williamlin108/Olympus-BH-2-LED-Module-G031xMAX20078/PCBfiles/3d_Lib/21-0136V_T16334C_MXM.step

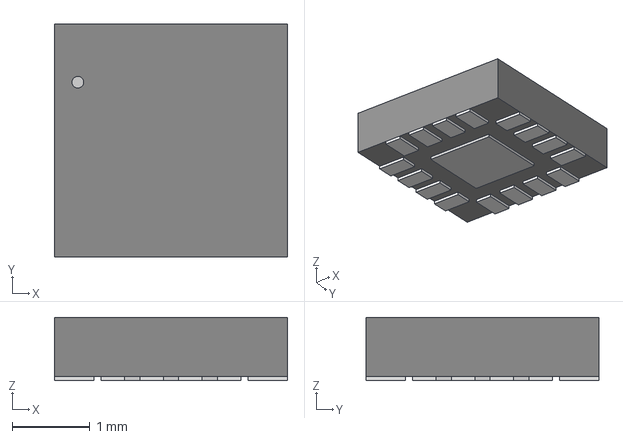
[picture p4: CAD file, 2026-10-14]
PCBfiles/3d_Lib/21-0136V_T16334C_MXM.step
3.00 x 3.00 x 0.815 mm
