williamlin108/Olympus-BH-2-LED-Module-G031xMAX20078/PCBfiles/3d_Lib/Molex_SPOX_5267.step

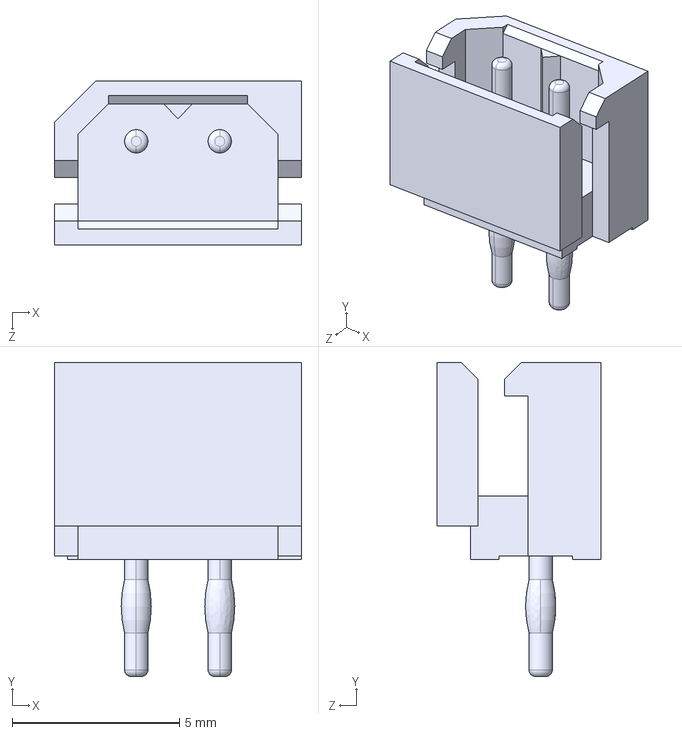
[picture p5: CAD file, 2026-10-14]
PCBfiles/3d_Lib/Molex_SPOX_5267.step
7.40 x 9.40 x 4.90 mm
