williamlin108/Olympus-BH-2-LED-Module-G031xMAX20078/PCBfiles/3d_Lib/d2f-01l3-t.stp

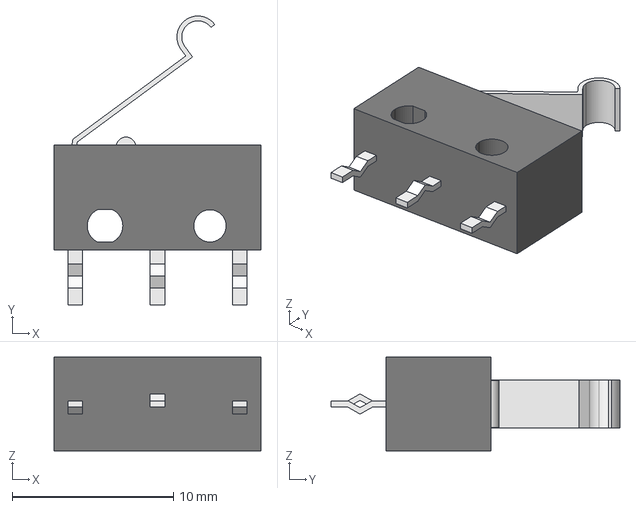
[picture p6: CAD file, 2026-10-14]
PCBfiles/3d_Lib/d2f-01l3-t.stp
12.8 x 17.9 x 5.80 mm
