williamlin108/Olympus-BH-2-LED-Module-G031xMAX20078/PCBfiles/3d_Lib/D2F_01FL2_A1.step

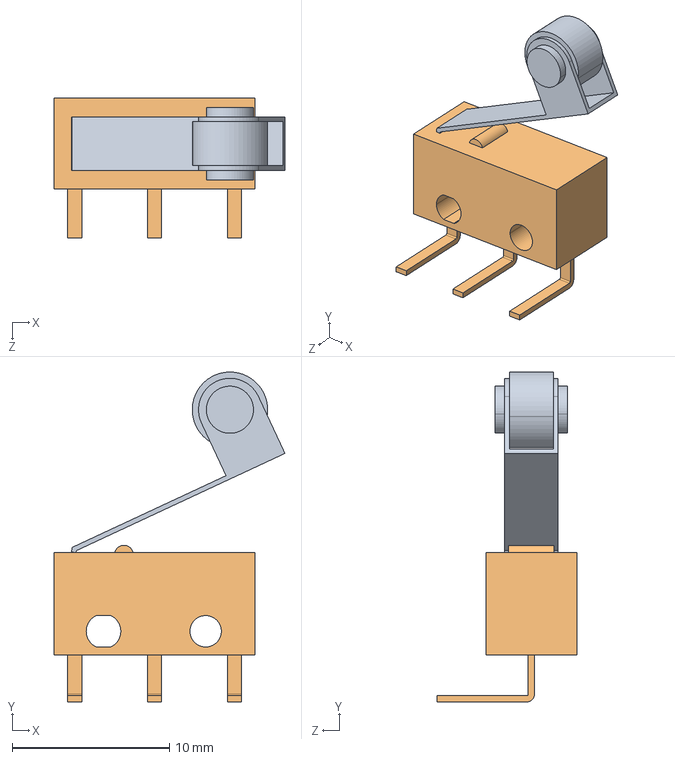
[picture p7: CAD file, 2026-10-14]
PCBfiles/3d_Lib/D2F_01FL2_A1.step
14.7 x 21.0 x 8.90 mm
D2F_01FL2_A1_ACTUATOR
D2F_01FL2_A1_BASE
