williamlin108/Olympus-BH-2-LED-Module-G031xMAX20078/PCBfiles/3d_Lib/infineon-pg-tison-8-4-3d-01-stp-package-en.stp

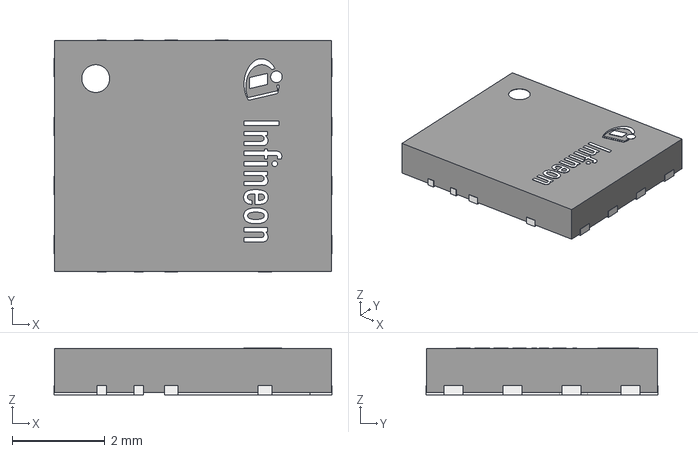
[picture p8: CAD file, 2026-10-14]
PCBfiles/3d_Lib/infineon-pg-tison-8-4-3d-01-stp-package-en.stp
6.00 x 5.00 x 1.01 mm
