williamlin108/Olympus-BH-2-LED-Module-G031xMAX20078/PCBfiles/3d_Lib/CYPD3177-24LQXQ--3DModel-STEP-510211.STEP

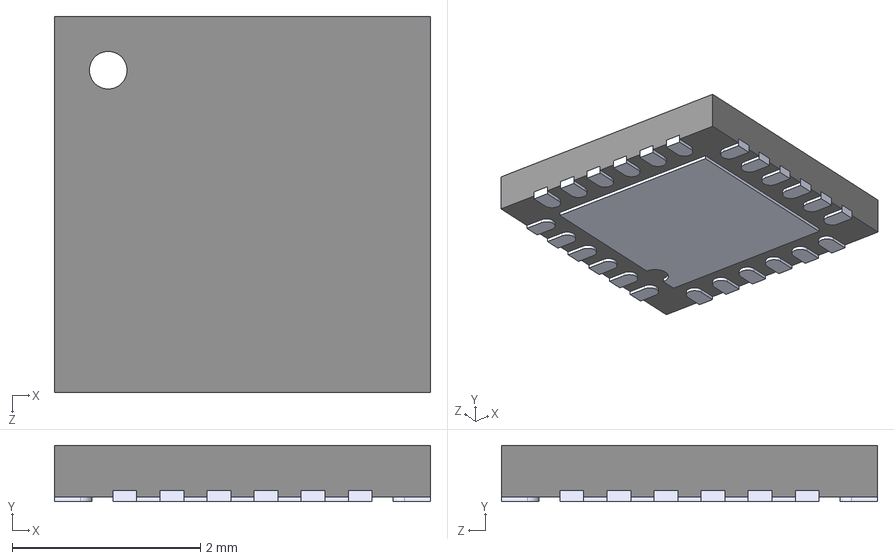
[picture p9: CAD file, 2026-10-14]
PCBfiles/3d_Lib/CYPD3177-24LQXQ--3DModel-STEP-510211.STEP
4.00 x 0.6 x 4.00 mm
EXPORT__Body__S01^QFN(2)_CYPD3177-24LQXQ
EXPORT__Body001__S01^QFN(2)_CYPD3177-24LQXQ
EXPORT__Body001__S02^QFN(2)_CYPD3177-24LQXQ
EXPORT__Body001__S03^QFN(2)_CYPD3177-24LQXQ
EXPORT__Body001__S04^QFN(2)_CYPD3177-24LQXQ
EXPORT__Body001__S05^QFN(2)_CYPD3177-24LQXQ
EXPORT__Body001__S06^QFN(2)_CYPD3177-24LQXQ
EXPORT__Body001__S07^QFN(2)_CYPD3177-24LQXQ
EXPORT__Body001__S08^QFN(2)_CYPD3177-24LQXQ
EXPORT__Body001__S09^QFN(2)_CYPD3177-24LQXQ
EXPORT__Body001__S10^QFN(2)_CYPD3177-24LQXQ
EXPORT__Body001__S11^QFN(2)_CYPD3177-24LQXQ
EXPORT__Body001__S12^QFN(2)_CYPD3177-24LQXQ
EXPORT__Body002__S01^QFN(2)_CYPD3177-24LQXQ
EXPORT__Body002__S02^QFN(2)_CYPD3177-24LQXQ
EXPORT__Body002__S03^QFN(2)_CYPD3177-24LQXQ
EXPORT__Body002__S04^QFN(2)_CYPD3177-24LQXQ
EXPORT__Body002__S05^QFN(2)_CYPD3177-24LQXQ
EXPORT__Body002__S06^QFN(2)_CYPD3177-24LQXQ
EXPORT__Body002__S07^QFN(2)_CYPD3177-24LQXQ
EXPORT__Body002__S08^QFN(2)_CYPD3177-24LQXQ
EXPORT__Body002__S09^QFN(2)_CYPD3177-24LQXQ
EXPORT__Body002__S10^QFN(2)_CYPD3177-24LQXQ
EXPORT__Body002__S11^QFN(2)_CYPD3177-24LQXQ
EXPORT__Body002__S12^QFN(2)_CYPD3177-24LQXQ
EXPORT__Body003__S01^QFN(2)_CYPD3177-24LQXQ
EXPORT__Body004__S01^QFN(2)_CYPD3177-24LQXQ
