williamlin108/Olympus-BH-2-LED-Module-G031xMAX20078/PCBfiles/3d_Lib/IHLP4040DZER4R7M01--3DModel-STEP-269445.STEP

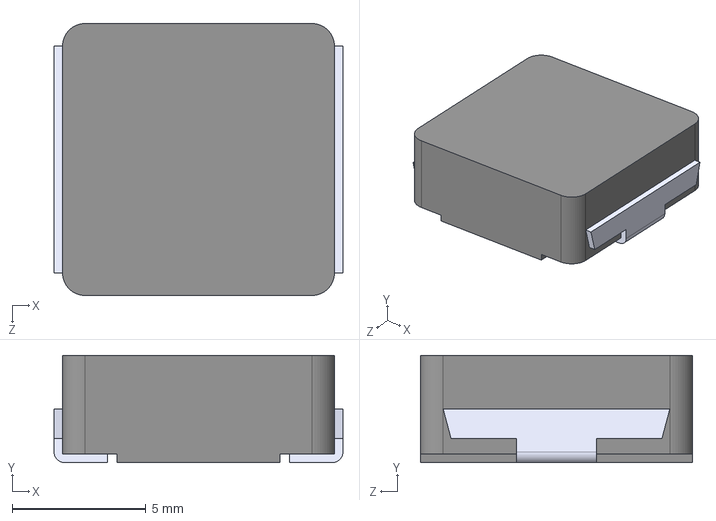
[picture p10: CAD file, 2026-10-14]
PCBfiles/3d_Lib/IHLP4040DZER4R7M01--3DModel-STEP-269445.STEP
10.8 x 4.00 x 10.2 mm
