williamlin108/Olympus-BH-2-LED-Module-G031xMAX20078/PCBfiles/3d_Lib/2082940020.step

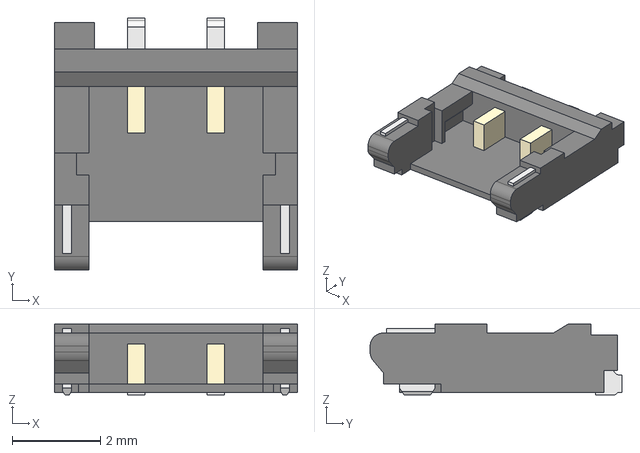
[picture p11: CAD file, 2026-10-14]
PCBfiles/3d_Lib/2082940020.step
5.50 x 5.70 x 1.60 mm
