williamlin108/Olympus-BH-2-LED-Module-G031xMAX20078/PCBfiles/CombinedLEDdriverMAX278.kicad_pcb

## KiCad design PCBfiles/CombinedLEDdriverMAX278.kicad_pcb (2026-10-14)

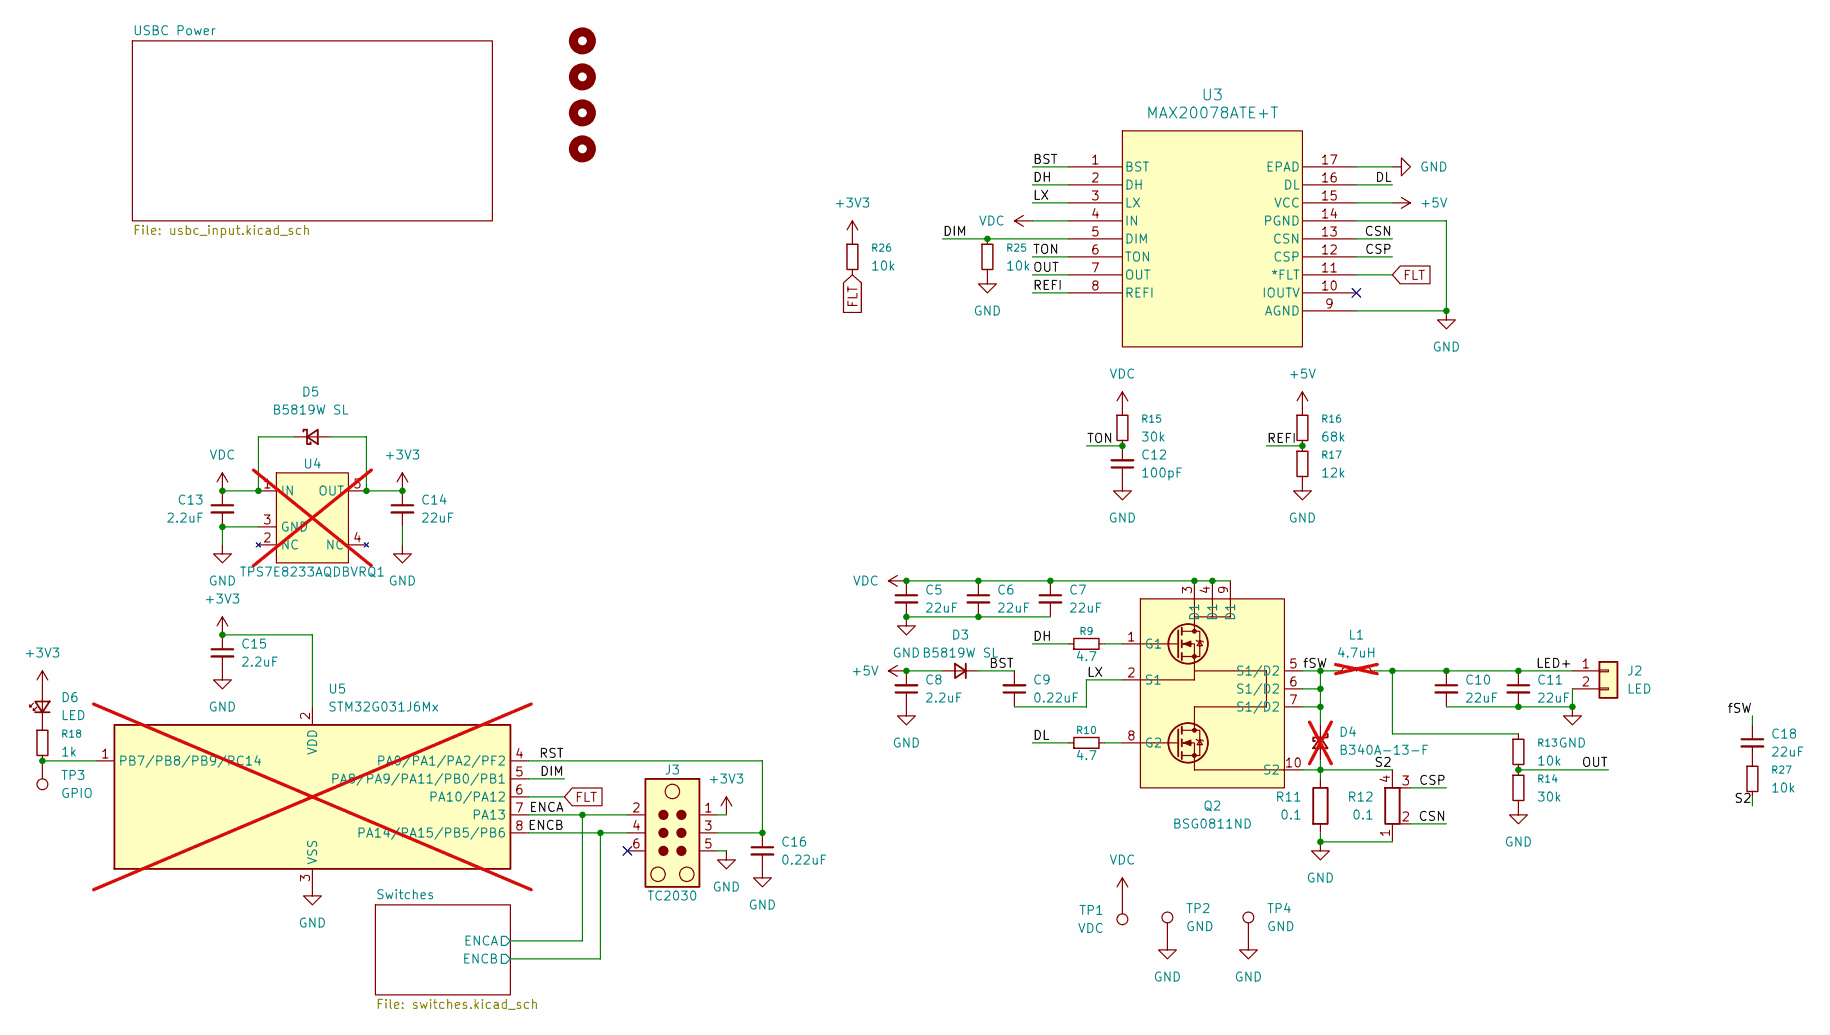
[picture p12: schematic CombinedLEDdriverMAX278.kicad_sch]

Parts:
C5, C6, C7, C10, C11, C14: 22uF; C_0805_2012Metric
C8, C13, C15: 2.2uF; C_0603_1608Metric
C9, C16: 0.22uF; C_0603_1608Metric
C12: 100pF; C_0603_1608Metric
C18: 22uF; C_0603_1608Metric_Pad1.08x0.95mm_HandSolder
D3, D5: B5819W SL; D_SOD-123
D4: B340A-13-F; D_SMA; not fitted
D6: LED; LED_0805_2012Metric
H1, H2, H3, H4: MountingHole; MountingHole_2.7mm_M2.5
J2: LED; Molex_SPOX_5267-02A_1x02_P2.50mm_Vertical
J3: TC2030; Tag-Connect_TC2030-IDC-NL_2x03_P1.27mm_Vertical
L1: 4.7uH; L_Vishay_IHLP-4040; not fitted
Q2: BSG0811ND; Infineon_PG-TISON-8-4
R9, R10: 4.7; R_0603_1608Metric
R11, R12: 0.1; R_0805_2012Metric
R13, R25, R26: 10k; R_0603_1608Metric
R14, R15: 30k; R_0603_1608Metric
R16: 68k; R_0603_1608Metric
R17: 12k; R_0603_1608Metric
R18: 1k; R_0603_1608Metric
R27: 10k; R_0603_1608Metric_Pad0.98x0.95mm_HandSolder
TP1: VDC; TestPoint_Pad_D1.0mm
TP2: GND; TestPoint_Pad_D1.0mm
TP3: GPIO; TestPoint_Pad_D1.0mm
TP4: GND; TestPoint_Keystone_5015_Micro_Mini
U3: MAX20078ATE+T; MAX20078_QFN
U4: TPS7E8233AQDBVRQ1; SOT-23-5; not fitted
U5: STM32G031J6Mx; SOIC-8_3.9x4.9mm_P1.27mm; not fitted

Connections:
+3V3: C14.1, C15.1, D5.2 (A), D6.2 (A), J3.1, R26.1, U4.5 (OUT), U5.2 (VDD); also elsewhere on the board
+5V: C8.2, D3.2 (A), R16.1, U3.15 (VCC)
/BST: C9.2, D3.1 (K), U3.1 (BST)
/CSN: R12.2, U3.13 (CSN)
/CSP: R12.3, U3.12 (CSP)
/DH: R9.1, U3.2 (DH)
/DIM: R25.1, U3.5 (DIM), U5.5 (PA8/PA9/PA11/PB0/PB1)
/DL: R10.1, U3.16 (DL)
/ENCA: J3.2, U5.7 (PA13); also elsewhere on the board
/ENCB: J3.4, U5.8 (PA14/PA15/PB5/PB6); also elsewhere on the board
/LED+: C10.1, C11.1, J2.1, L1.2, R13.1
/LX: C9.1, Q2.2 (S1), U3.3 (LX)
/OUT: R13.2, R14.1, U3.7 (OUT)
/REFI: R16.2, R17.1, U3.8 (REFI)
/RST: C16.1, J3.3, U5.4 (PA0/PA1/PA2/PF2)
/S2: D4.2 (A), Q2.10 (S2), R11.1, R12.4, R27.2
/TON: C12.2, R15.2, U3.6 (TON)
/fSW: C18.1, D4.1 (K), L1.1, Q2.5 (S1/D2), Q2.6 (S1/D2), Q2.7 (S1/D2)
FLT: R26.2, U3.11 (*FLT), U5.6 (PA10/PA12)
GND: C5.2, C6.2, C7.2, C8.1, C10.2, C11.2, C12.1, C13.2, C14.2, C15.2, C16.2, J2.2, J3.5, R11.2, R12.1, R14.2, R17.2, R25.2, TP2.1, TP4.1, U3.9 (AGND), U3.14 (PGND), U3.17 (EPAD), U4.3 (GND), U5.3 (VSS); also elsewhere on the board
unnamed: C18.2, R27.1
unnamed: D6.1 (K), R18.1
unnamed: Q2.1 (G1), R9.2
unnamed: Q2.8 (G2), R10.2
unnamed: R18.2, TP3.1, U5.1 (PB7/PB8/PB9/PC14)
VDC: C5.1, C6.1, C7.1, C13.1, D5.1 (K), Q2.3 (D1), Q2.4 (D1), Q2.9 (D1), R15.1, TP1.1, U3.4 (IN), U4.1 (IN); also elsewhere on the board

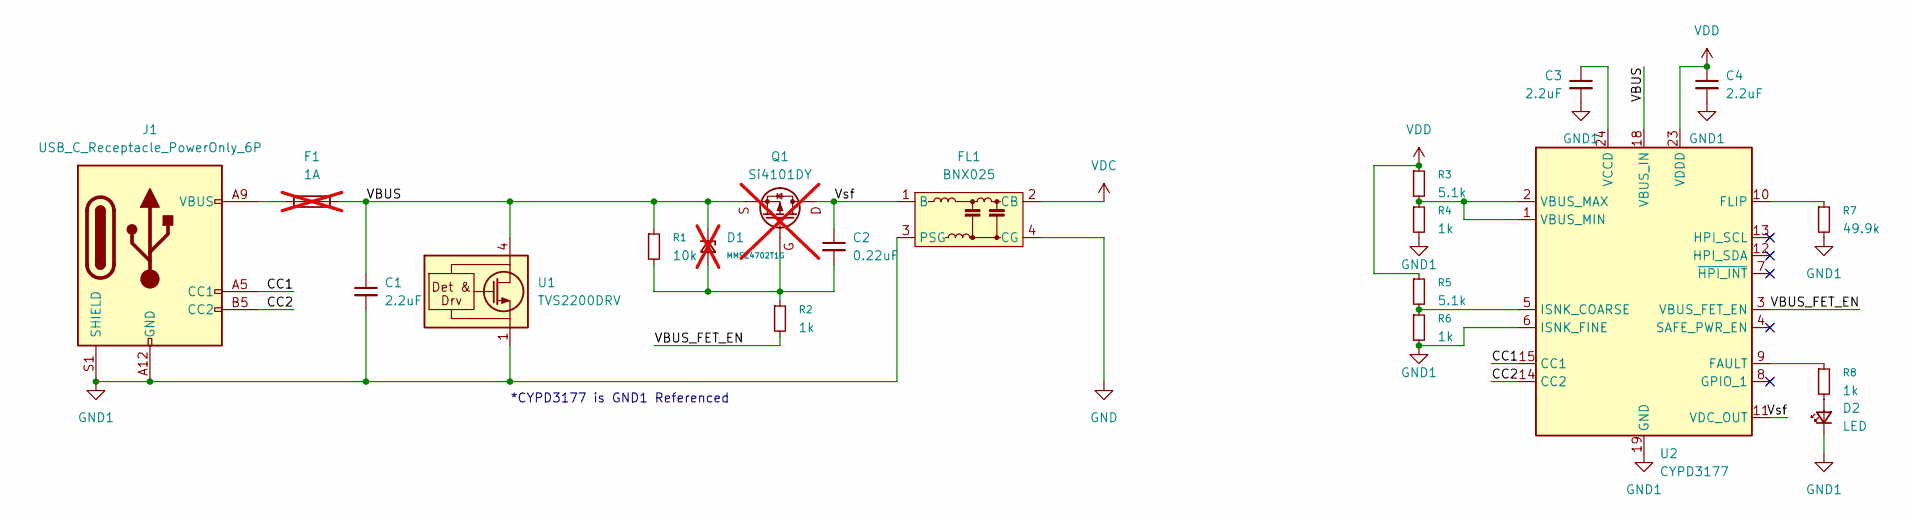
[picture p13: schematic usbc_input.kicad_sch]

Parts:
C1, C3, C4: 2.2uF; C_0603_1608Metric
C2: 0.22uF; C_0603_1608Metric
D1: MMSZ4702T1G; D_SOD-123; not fitted
D2: LED; LED_0805_2012Metric
F1: 1A; Fuse_1206_3216Metric_Pad1.42x1.75mm_HandSolder; not fitted
FL1: BNX025; Filter_Murata_BNX025
J1: USB_C_Receptacle_PowerOnly_6P; USB_C_Receptacle_GCT_USB4125-xx-x_6P_TopMnt_Horizontal
Q1: Si4101DY; SOIC-8_3.9x4.9mm_P1.27mm; not fitted
R1: 10k; R_0603_1608Metric
R2, R4, R6, R8: 1k; R_0603_1608Metric
R3, R5: 5.1k; R_0603_1608Metric
R7: 49.9k; R_0603_1608Metric
U1: TVS2200DRV; WSON-6-1EP_2x2mm_P0.65mm_EP1x1.6mm
U2: CYPD3177; QFN-24-1EP_4x4mm_P0.5mm_EP2.75x2.75mm

Connections:
/USBC Power/CC1: J1.A5 (CC1), U2.15 (CC1)
/USBC Power/CC2: J1.B5 (CC2), U2.14 (CC2)
/USBC Power/VBUS: C1.1, D1.1 (K), F1.2, Q1.1 (S), Q1.2 (S), Q1.3 (S), R1.1, U1.4 (IN), U1.5 (IN), U1.6 (IN), U2.18 (VBUS_IN)
/USBC Power/VBUS_FET_EN: R2.2, U2.3 (VBUS_FET_EN)
/USBC Power/Vsf: C2.1, FL1.1 (B), Q1.5 (D), Q1.6 (D), Q1.7 (D), Q1.8 (D), U2.11 (VDC_OUT)
GND: FL1.4 (CG); also elsewhere on the board
GND1: C1.2, C3.2, C4.2, D2.1 (K), FL1.3 (PSG), J1.A12 (GND), J1.B12 (GND), J1.S1 (SHIELD), R4.2, R6.2, R7.2, U1.1 (GND), U1.2 (GND), U1.3 (GND), U1.7 (GND), U2.6 (ISNK_FINE), U2.19 (GND), U2.22 (GND), U2.25 (GND)
unnamed: C2.2, D1.2 (A), Q1.4 (G), R1.2, R2.1
unnamed: D2.2 (A), R8.2
unnamed: F1.1, J1.A9 (VBUS), J1.B9 (VBUS)
unnamed: R8.1, U2.9 (FAULT)
unnamed: R7.1, U2.10 (FLIP)
unnamed: R5.2, R6.1, U2.5 (ISNK_COARSE)
unnamed: R3.2, R4.1, U2.1 (VBUS_MIN), U2.2 (VBUS_MAX)
unnamed: C3.1, U2.24 (VCCD)
VDC: FL1.2 (CB); also elsewhere on the board
VDD: C4.1, R3.1, R5.1, U2.23 (VDDD)

Notes on the sheet:
*CYPD3177 is GND1 Referenced

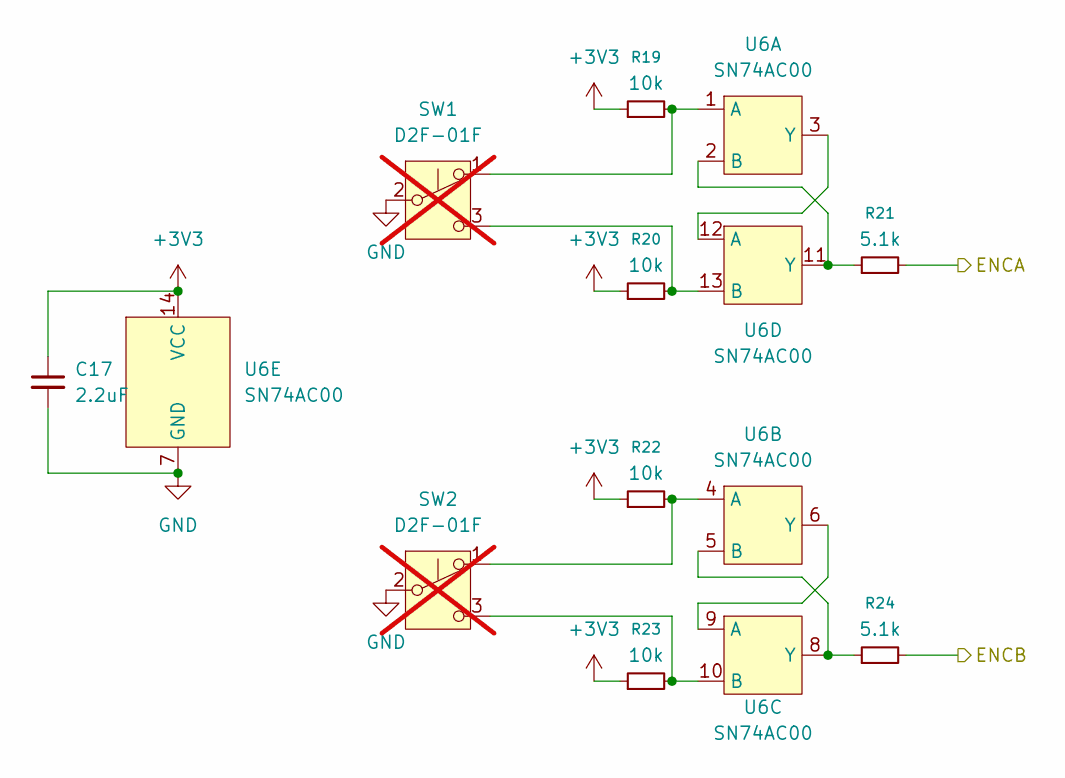
[picture p14: schematic switches.kicad_sch]

Parts:
C17: 2.2uF; C_0603_1608Metric
R19, R20, R22, R23: 10k; R_0603_1608Metric
R21, R24: 5.1k; R_0603_1608Metric
SW1, SW2: D2F-01F; not fitted
U6: SN74AC00; TSSOP-14_4.4x5mm_P0.65mm

Connections:
+3V3: C17.1, R19.1, R20.1, R22.1, R23.1, U6.14 (VCC); also elsewhere on the board
/ENCA: R21.2; also elsewhere on the board
/ENCB: R24.2; also elsewhere on the board
GND: C17.2, SW1.2 (B), SW2.2 (B), U6.7 (GND); also elsewhere on the board
unnamed: R19.2, SW1.1 (A), U6.1 (A)
unnamed: R20.2, SW1.3 (C), U6.13 (B)
unnamed: R22.2, SW2.1 (A), U6.4 (A)
unnamed: R23.2, SW2.3 (C), U6.10 (B)
unnamed: R21.1, U6.2 (B), U6.11 (Y)
unnamed: U6.3 (Y), U6.12 (A)
unnamed: R24.1, U6.5 (B), U6.8 (Y)
unnamed: U6.6 (Y), U6.9 (A)

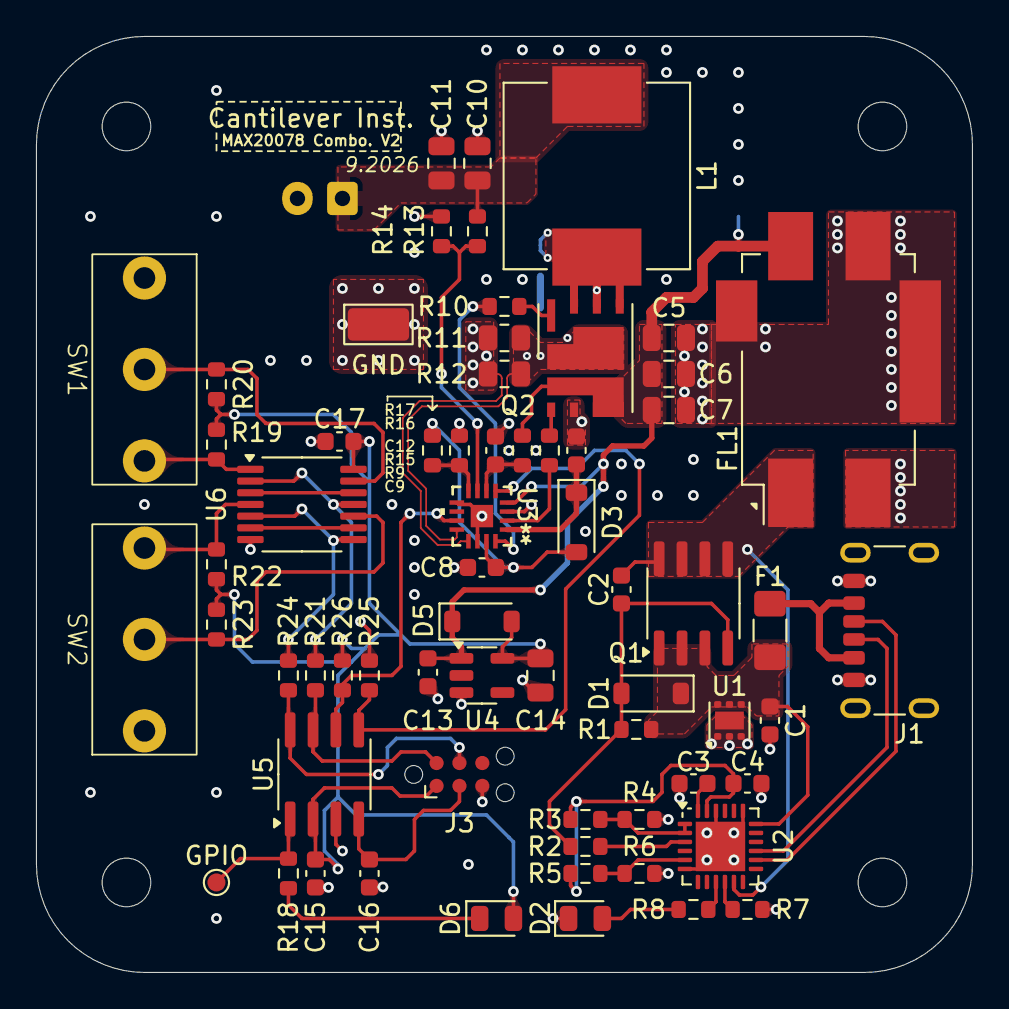
[picture p15: board CombinedLEDdriverMAX278.kicad_pcb from above]

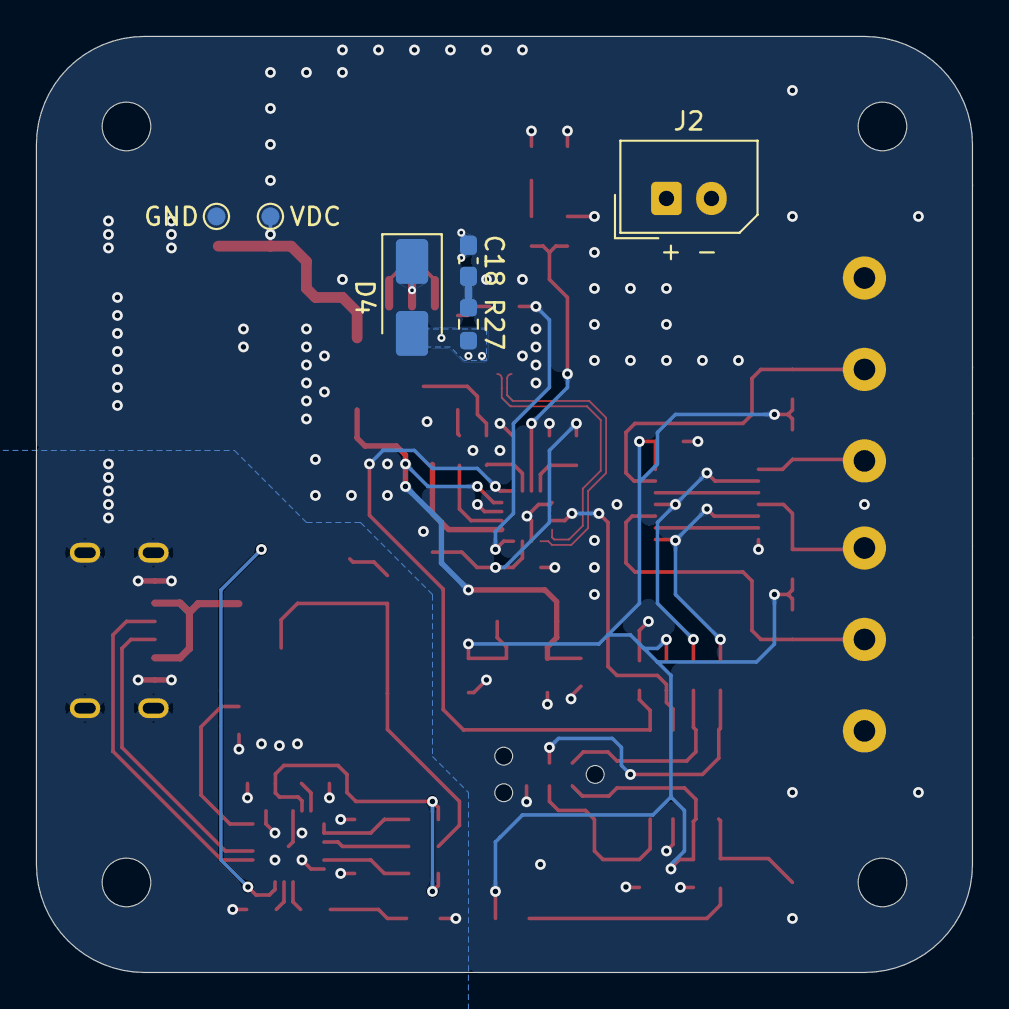
[picture p16: board CombinedLEDdriverMAX278.kicad_pcb from below]

Board: 4 copper layers, 52.0 x 52.0 mm, 75 parts (6 on the bottom side), 49 nets.
