williamlin108/Olympus-BH-2-LED-Module-G031xMAX20078/Firmware/combi278/Core/Inc/main.h

#define LED_Pin GPIO_PIN_7
#define LED_GPIO_Port GPIOB
#define PWM_Pin GPIO_PIN_0
#define PWM_GPIO_Port GPIOB
#define FLT_Pin GPIO_PIN_12
#define FLT_GPIO_Port GPIOA
#define FLT_EXTI_IRQn EXTI4_15_IRQn
#define INCU_Pin GPIO_PIN_13
#define INCU_GPIO_Port GPIOA
#define INCD_Pin GPIO_PIN_15
#define INCD_GPIO_Port GPIOA
