williamlin108/Olympus-BH-2-LED-Module-G031xMAX20078/(commit log)

2026-10-14 Add KiCad PCB files, STM32G031 firmware, images, and updated README
    Add .gitignore for KiCad backups/lock files and STM32CubeIDE build output.
2026-10-14 Remove deprecated STM32G431 firmware
2026-10-14 Add image of Combined LED driver to README
